NexRobotic/Project-Recon-Quadbot/Electronics/IMG_7864.JPG

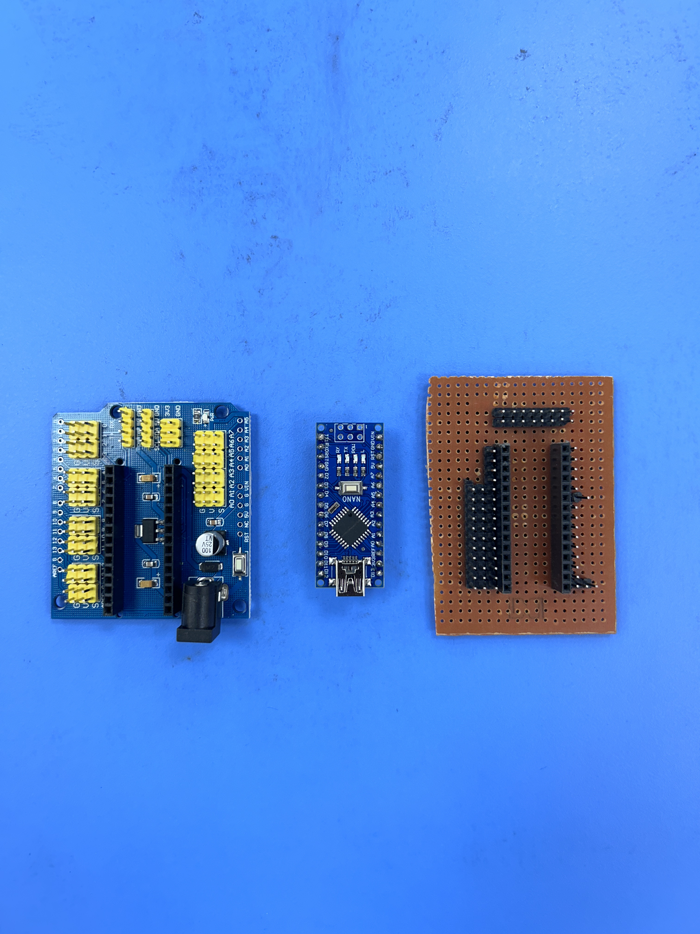
Electronics/IMG_7864.JPG
