NexRobotic/Project-Recon-Quadbot/Electronics/IMG_0209.jpg

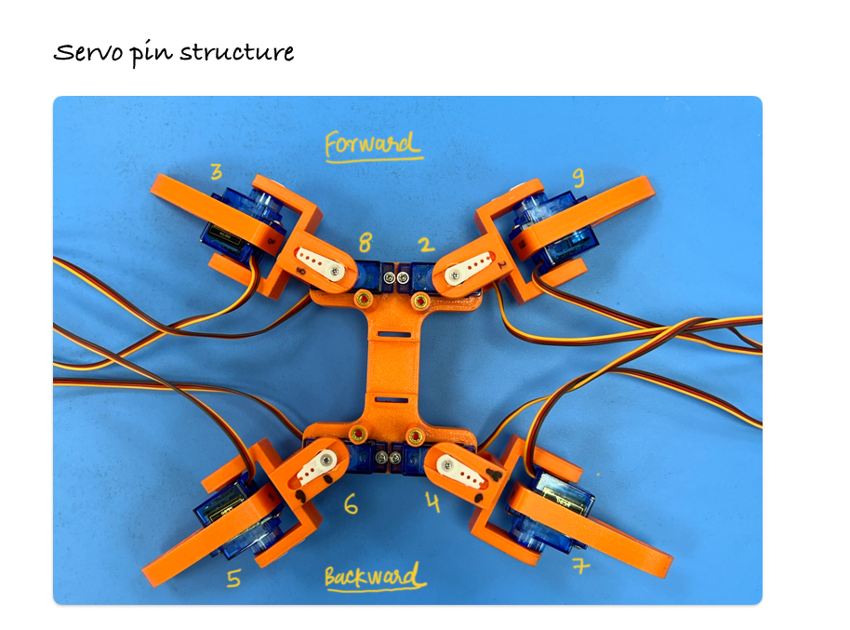
Electronics/IMG_0209.jpg
