NexRobotic/Project-Recon-Quadbot/3D Files/Recon 3d Files/images/7b0f1db2eef30604777a560330b7dbc6.png

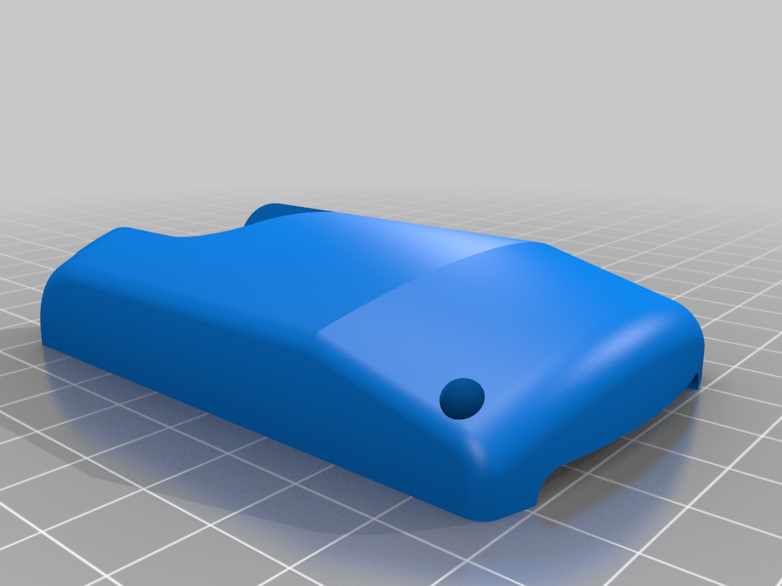
3D Files/Recon 3d Files/images/7b0f1db2eef30604777a560330b7dbc6.png
