NexRobotic/Project-Recon-Quadbot/3D Files/Recon 3d Files/images/612a9abf6b828723afef858f10744501.png

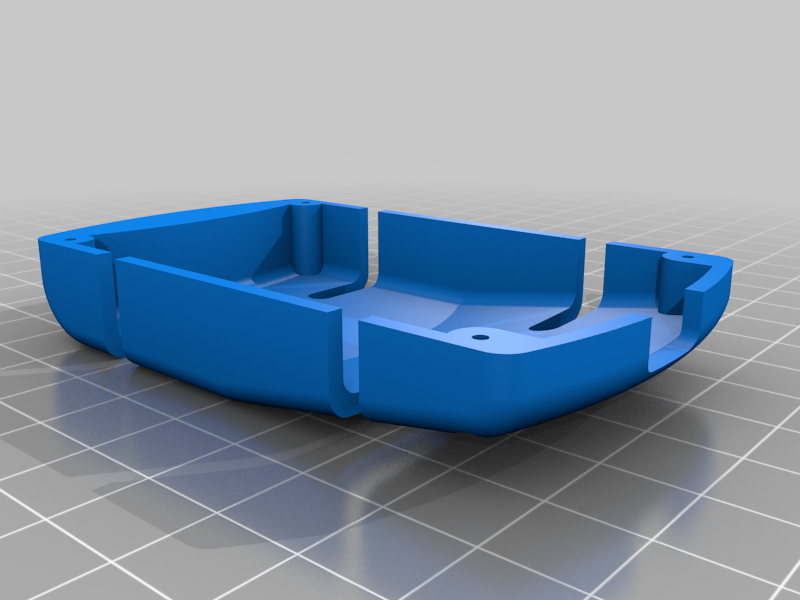
3D Files/Recon 3d Files/images/612a9abf6b828723afef858f10744501.png
