NexRobotic/Project-Recon-Quadbot/3D Files/Recon 3d Files/images/4812d3d8d440bcd925ab89b01c84c059.png

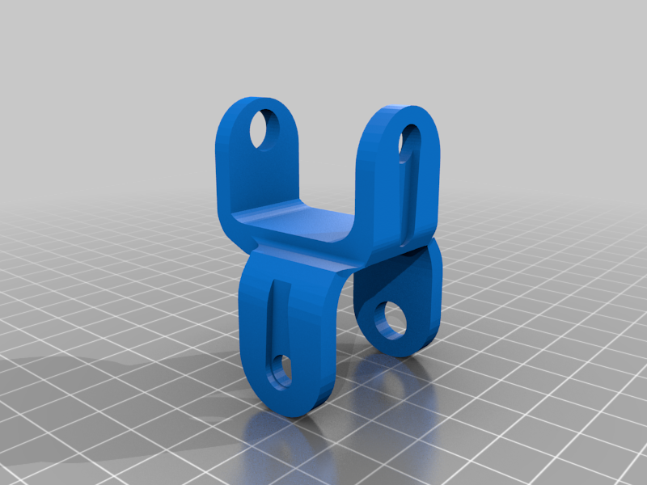
3D Files/Recon 3d Files/images/4812d3d8d440bcd925ab89b01c84c059.png
