NexRobotic/Project-Recon-Quadbot/3D Files/Recon 3d Files/images/a9755487723da7518c1324117bf25b60.png

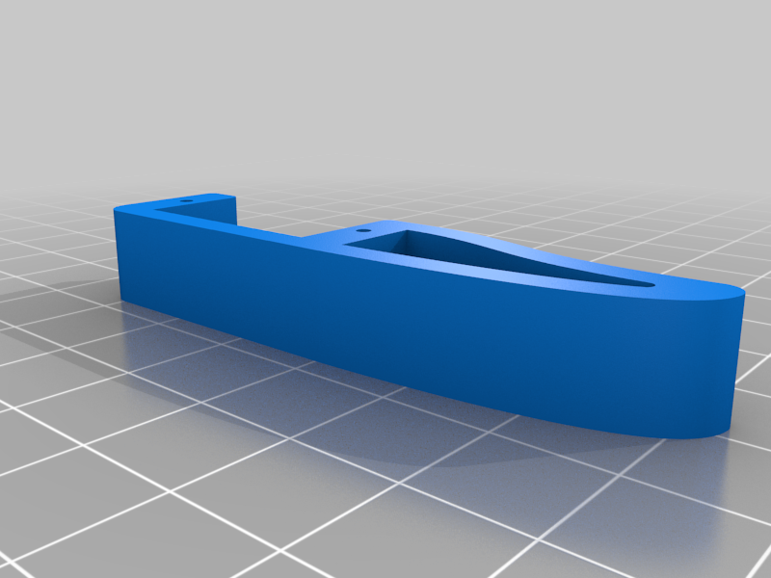
3D Files/Recon 3d Files/images/a9755487723da7518c1324117bf25b60.png
