NexRobotic/Project-Recon-Quadbot/3D Files/Recon 3d Files/images/b7c1b67290ea0a6e60ebb349d8af4863.png

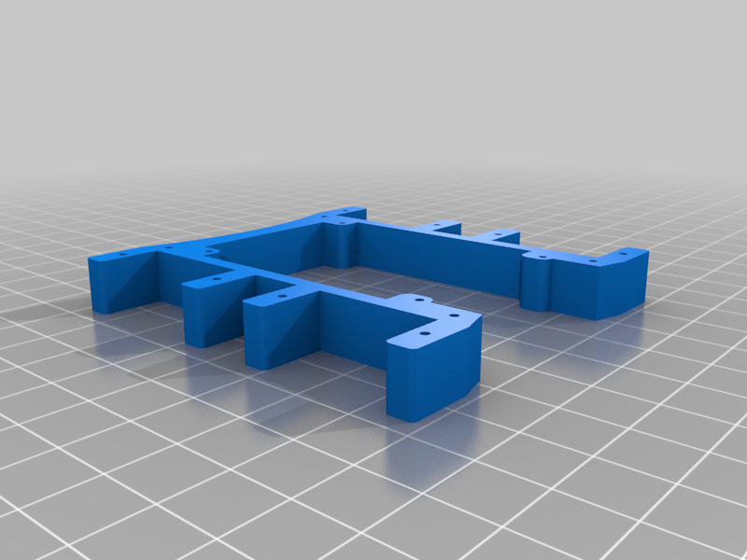
3D Files/Recon 3d Files/images/b7c1b67290ea0a6e60ebb349d8af4863.png
