NexRobotic/Project-Recon-Quadbot/Electronics/IMG_0207.jpg

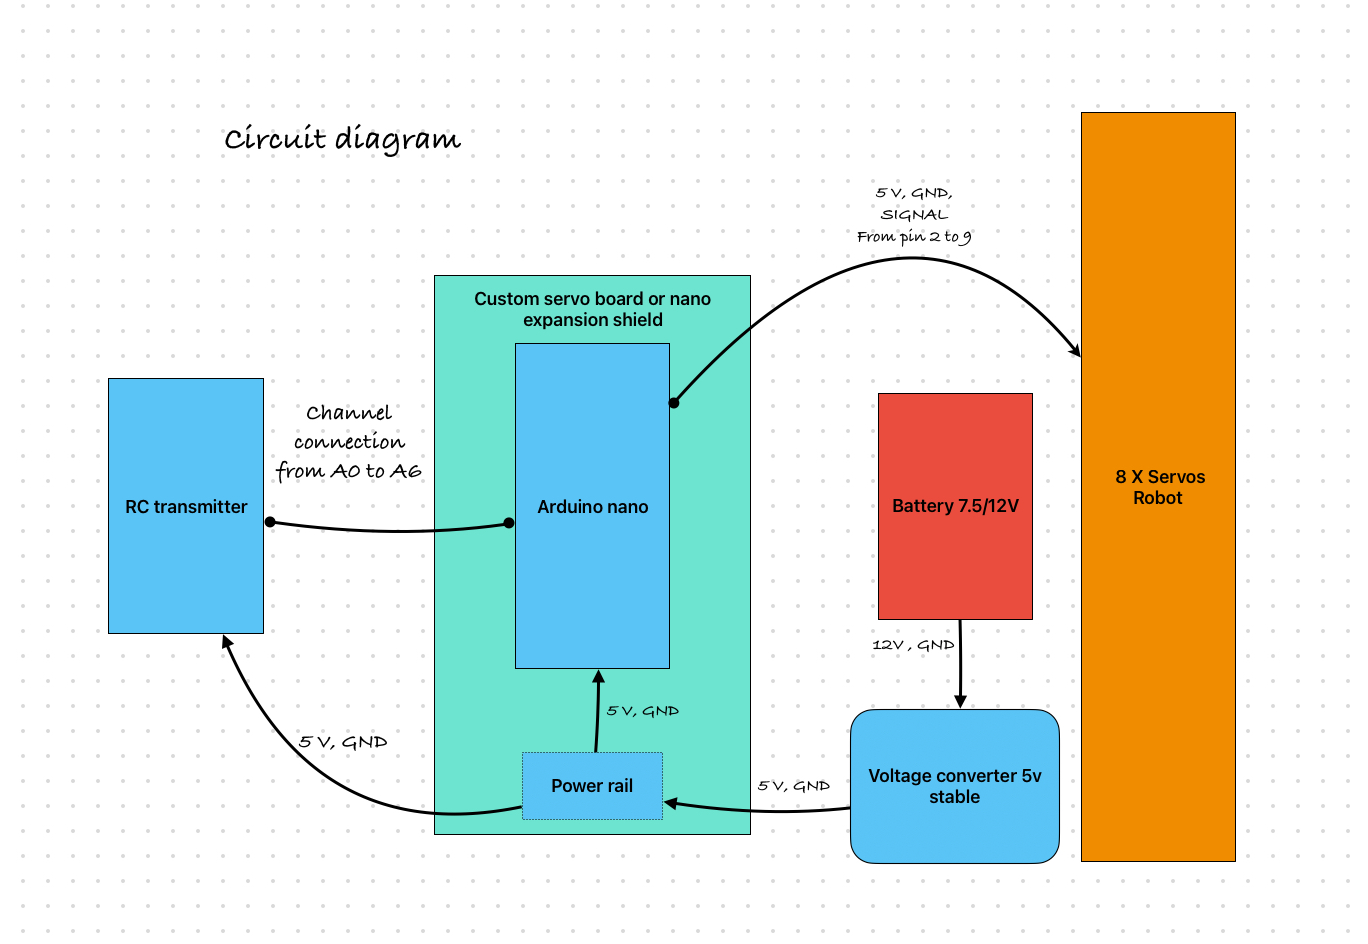
Electronics/IMG_0207.jpg
