NexRobotic/Project-Recon-Quadbot/Electronics/IMG_0208.jpg

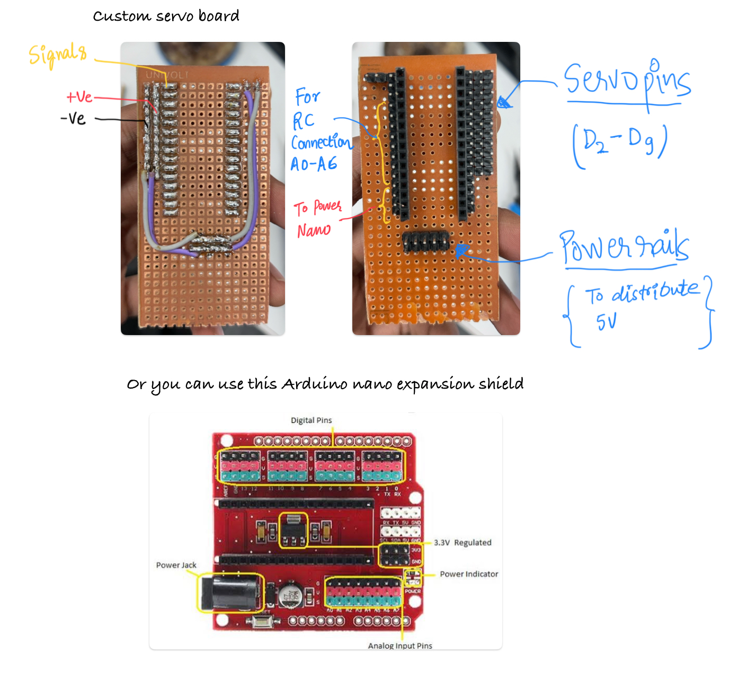
Electronics/IMG_0208.jpg
