NexRobotic/Project-Recon-Quadbot/Electronics/IMG_7529.JPG

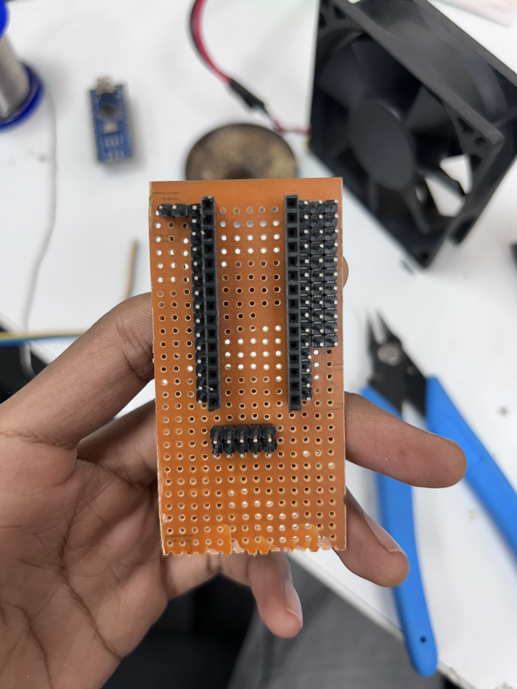
Electronics/IMG_7529.JPG
