NexRobotic/Project-Recon-Quadbot/Electronics/IMG_7530.JPG

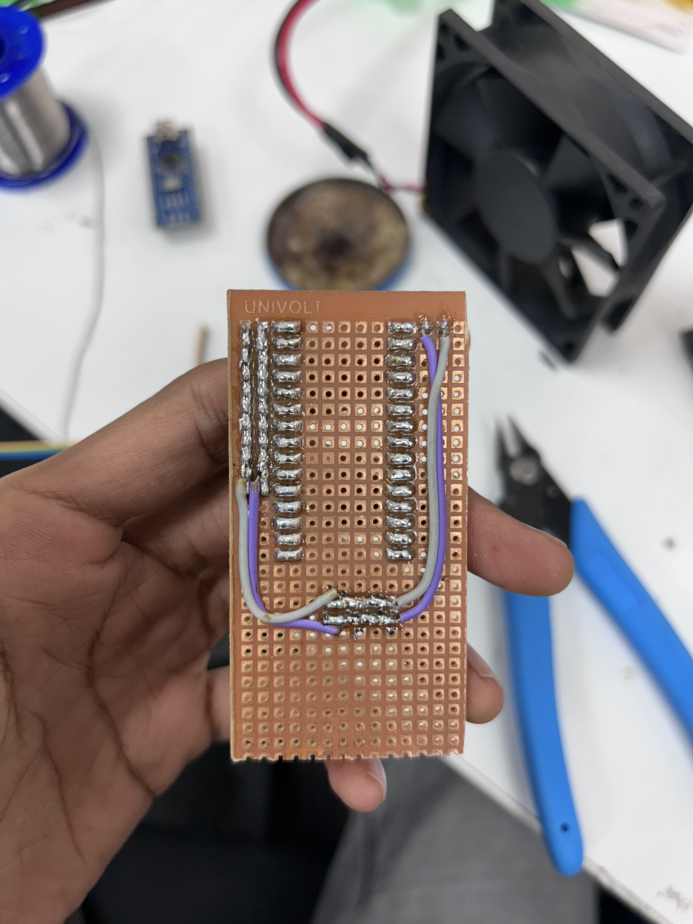
Electronics/IMG_7530.JPG
