NexRobotic/Project-Recon-Quadbot/Electronics/IMG_7531.JPG

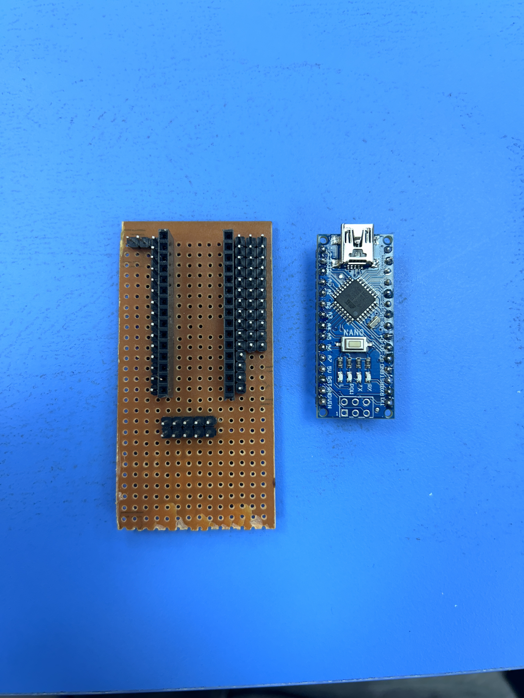
Electronics/IMG_7531.JPG
