NexRobotic/Project-Recon-Quadbot/Electronics/IMG_7532.JPG

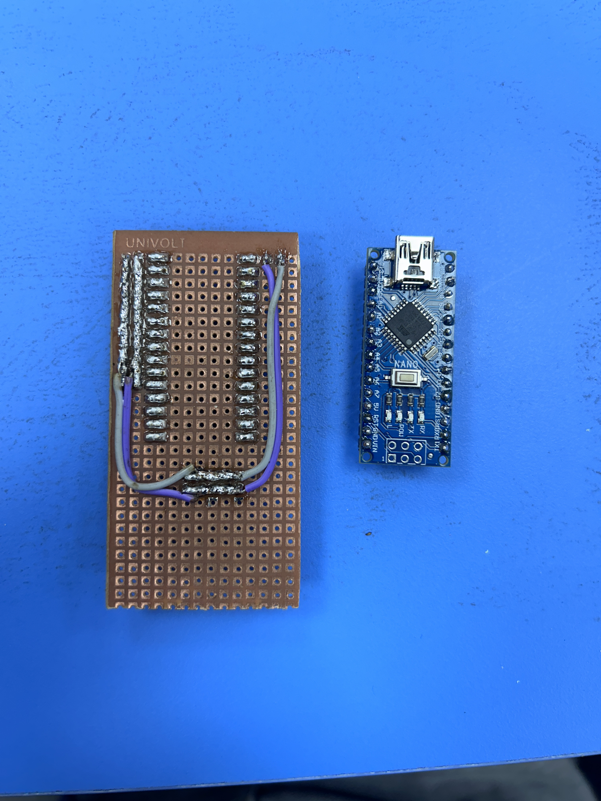
Electronics/IMG_7532.JPG
