NexRobotic/Project-Recon-Quadbot/3D Files/Recon 3d Files/files/Femur V2/Femur PT (3).stl

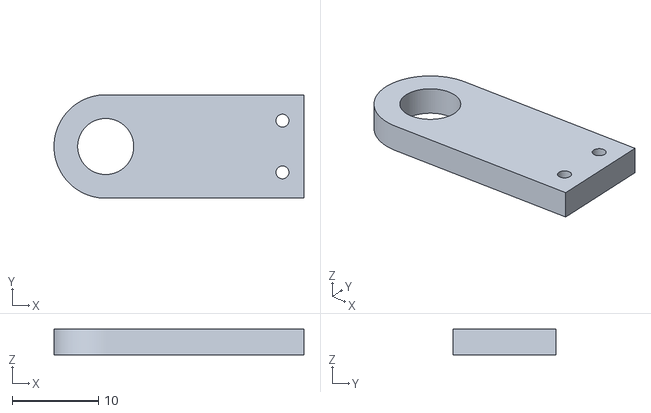
[picture p15: CAD file, 2024-10-08]
3D Files/Recon 3d Files/files/Femur V2/Femur PT (3).stl
29.0 x 12.0 x 3.00
