NexRobotic/Project-Recon-Quadbot/3D Files/Recon 3d Files/files/leg.stl

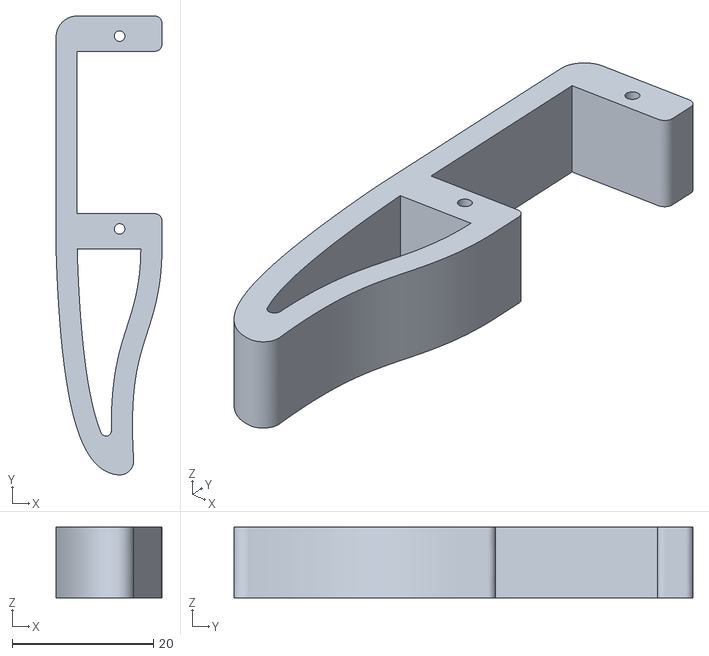
[picture p16: CAD file, 2024-10-08]
3D Files/Recon 3d Files/files/leg.stl
15.0 x 65.0 x 10.0
