NexRobotic/Project-Recon-Quadbot/3D Files/Recon 3d Files/files/bodyCover.stl

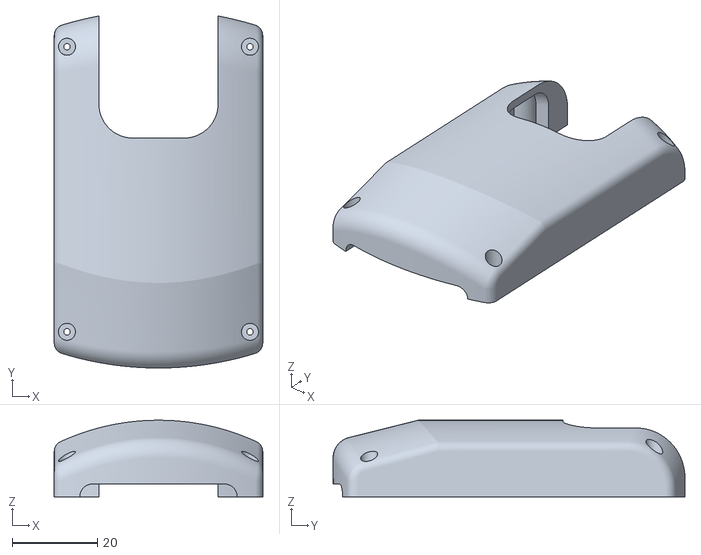
[picture p17: CAD file, 2024-10-08]
3D Files/Recon 3d Files/files/bodyCover.stl
49.0 x 82.7 x 18.0
