NexRobotic/Project-Recon-Quadbot/3D Files/Recon 3d Files/files/Femur V2/servoBottom.stl

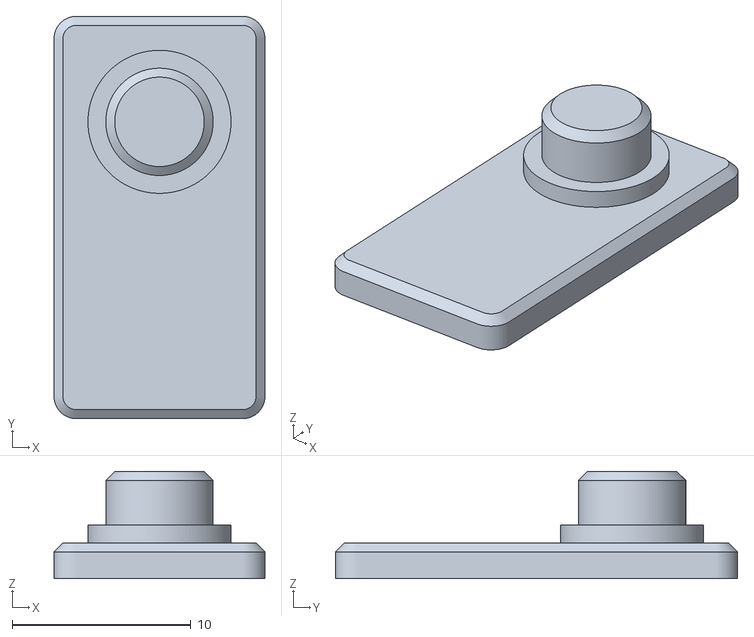
[picture p18: CAD file, 2024-10-08]
3D Files/Recon 3d Files/files/Femur V2/servoBottom.stl
11.8 x 22.5 x 6.00
