NexRobotic/Project-Recon-Quadbot/3D Files/Recon 3d Files/files/body.stl

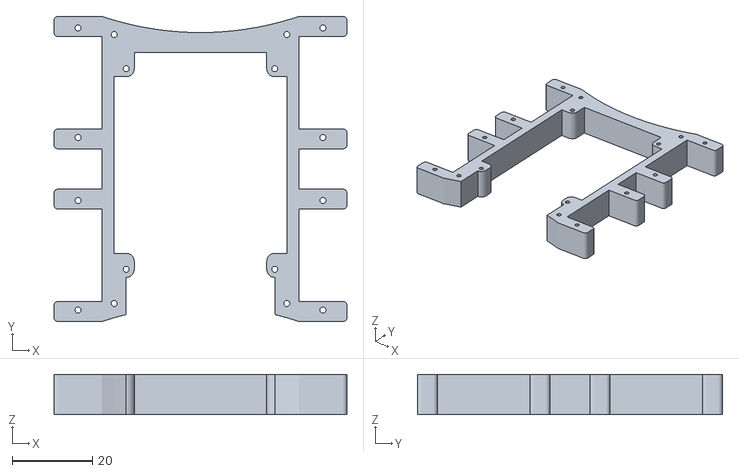
[picture p19: CAD file, 2024-10-08]
3D Files/Recon 3d Files/files/body.stl
73.0 x 76.0 x 10.0
