NexRobotic/Project-Recon-Quadbot/3D Files/Recon 3d Files/files/bodyBottom.stl

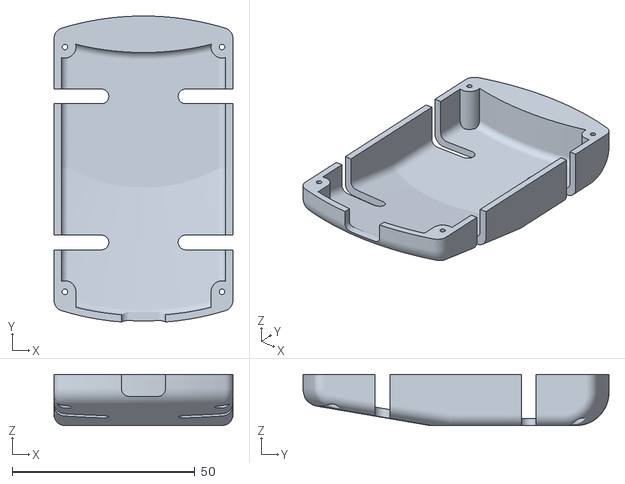
[picture p21: CAD file, 2024-10-08]
3D Files/Recon 3d Files/files/bodyBottom.stl
49.0 x 83.8 x 14.0
