NexRobotic/Project-Recon-Quadbot/3D Files/Recon 3d Files/files/Femur V2/Femur PT (1).stl

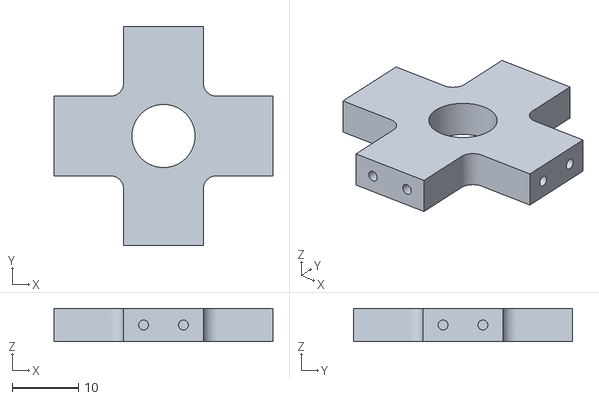
[picture p22: CAD file, 2024-10-08]
3D Files/Recon 3d Files/files/Femur V2/Femur PT (1).stl
33.0 x 33.0 x 5.00
