NexRobotic/Project-Recon-Quadbot/3D Files/Recon 3d Files/files/femur.STL

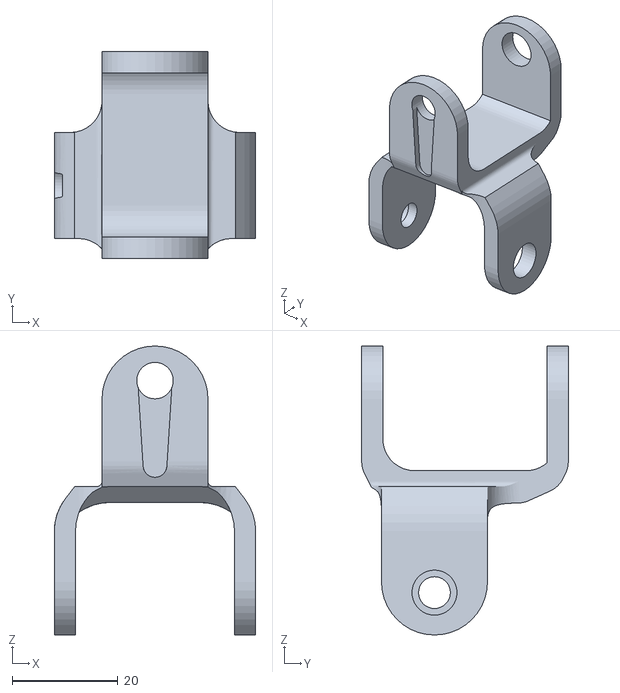
[picture p23: CAD file, 2024-10-08]
3D Files/Recon 3d Files/files/femur.STL
38.0 x 39.0 x 54.5
