NexRobotic/Project-Recon-Quadbot/Electronics/IMG_7862.JPG

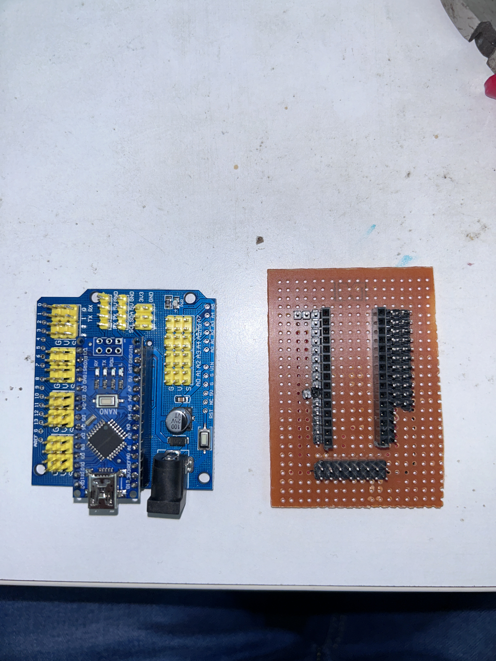
Electronics/IMG_7862.JPG
